ai03-2725/Orbit/OrbitX-PCB/Elecrow/OrbitX-Firmware-Flashing.docx

Firmware file is ai03_orbit_x_via.hex

Install instructions:

1. If computer does not have drivers for atmega32u4:
  a. Open qmk_toolbox.exe
  b. When QMK toolbox asks to install drivers, select Yes.

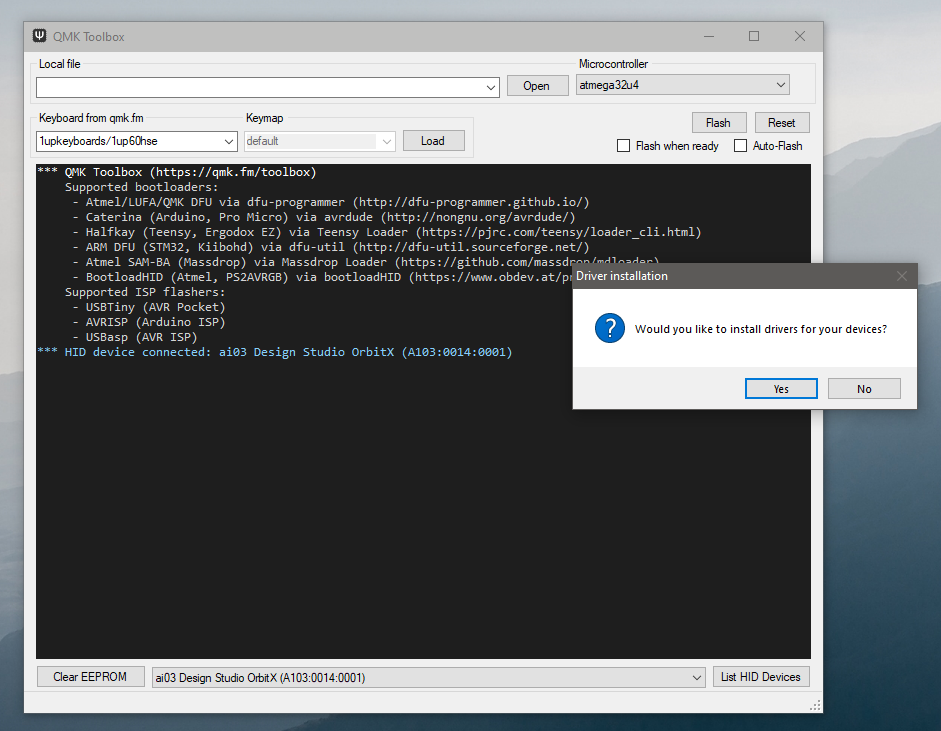
[picture p1: figure]

  c. The drivers will install slowly.

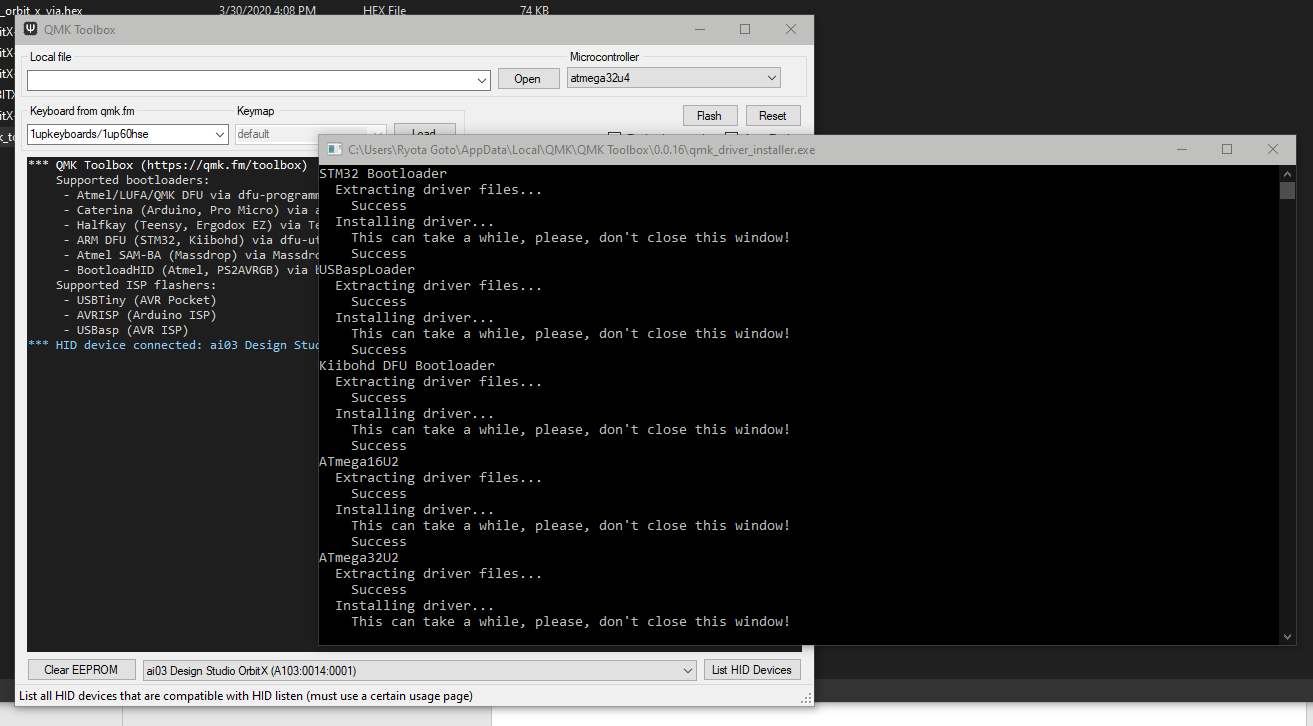
[picture p2: figure]

  d. Restart computer to finish driver install.
2. After drivers are installed, open qmk_toolbox.exe.
3. Click the Open button under “Local File”, and select the firmware file ai03_orbit_x_via.hex. /

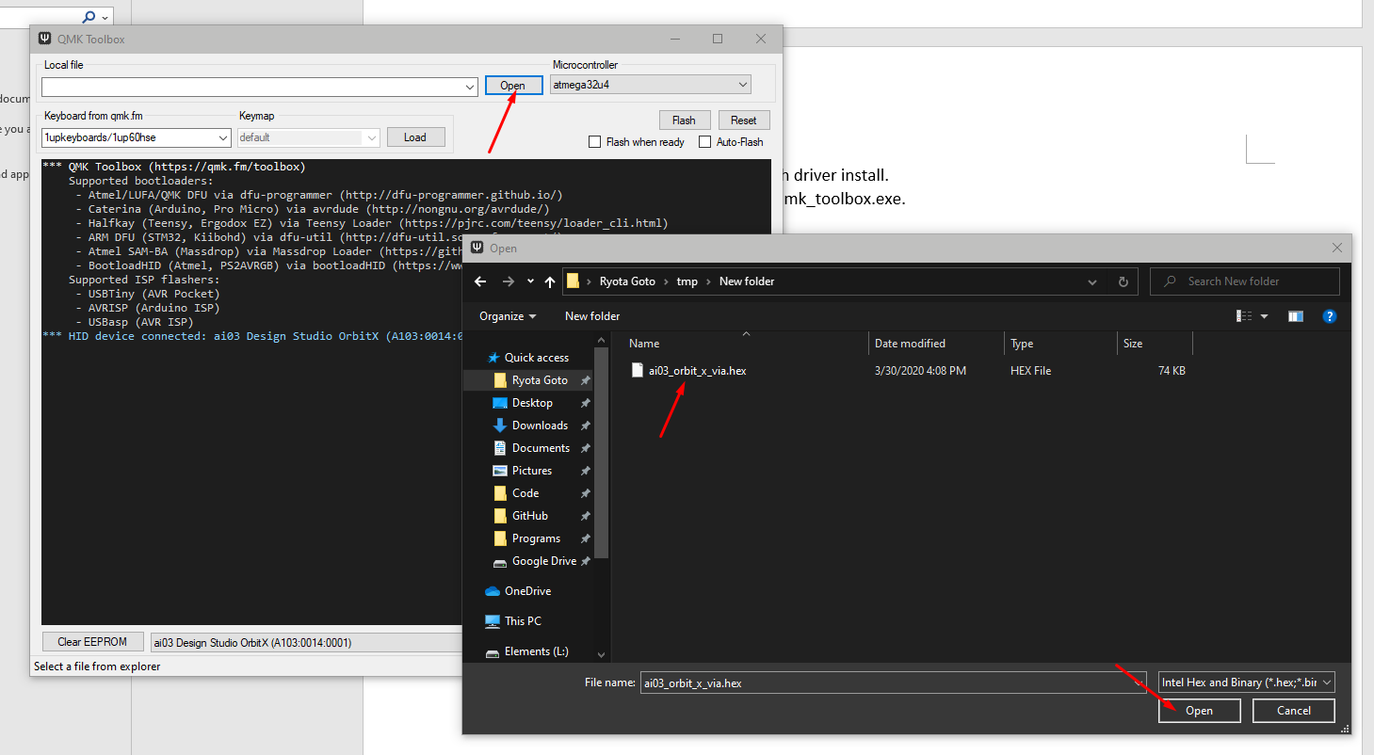
[picture p3: figure]

4. Select atmega32u4 for Microcontroller, and turn on “Flash when ready”.

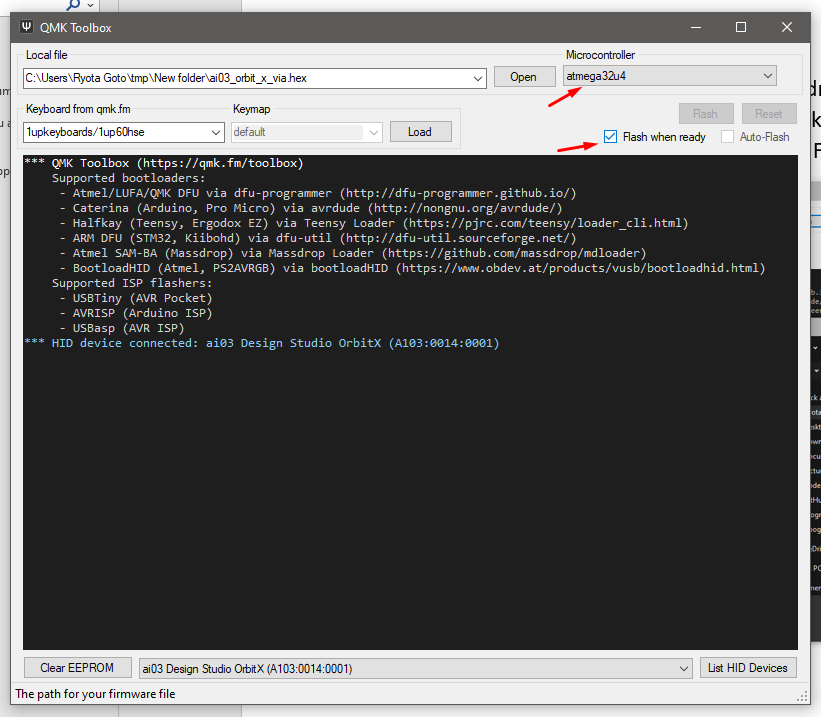
[picture p4: figure]

5. Connect the PCB. Firmware will automatically flash, and the device will appear as “ai03 Design Studio OrbitX” after success.
