ai03-2725/Orbit/OrbitX-PCB/JLCPCB/JLCSMT_Sample_BOM1.xlsx

Comment | Designator | Footprint | LCSC Part #（optional）
100nF | C4 C5 C6 C11 C12 C13 C15 C16 | C_0603_1608Metric | C14663
10uF | C7 C14 | C_0603_1608Metric | C19702
1uF | C3 C10 | C_0603_1608Metric | C15849
22pF | C1 C2 C8 C9 | C_0603_1608Metric | C1653
Schottky | D75 D76 | D_SOD-123 | C162059
1N4148 | D1 D2 D3 D4 D5 D6 D7 D8 D9 D10 D11 D12 D13 D14 D15 D16 D17 D18 D19 D20 D21 D22 D23 D24 D25 D26 D27 D28 D29 D30 D31 D32 D33 D34 D35 D36 D37 D38 D39 D40 D41 D42 D43 D44 D45 D46 D47 D48 | D_SOD-123 | C81598
Polyfuse 500mA | F1 F2 | Fuse_1206_3216Metric | C369159
10KΩ | R25 R67 R87 R88 | R_0603 | C25804
22Ω | R41 R42 R83 R84 | R_0603 | C23345
4.7KΩ | R9 R10 | R_0603 | C23162
5.1KΩ | R43 R44 R85 R86 | R_0603 | C23186
ATMEGA32u4-AU | U1 U3 | TQFP-44_10x10mm_P0.8mm | C44854
Crystal 16MHz | Y1 Y2 | Crystal_SMD_3225-4Pin_3.2x2.5mm | C13738
SW_Push | SW1 SW2 | SKQGADE010 | C318884
