ai03-2725/Orbit/OrbitX-PCB/Elecrow/OrbitX-Quote.xlsx

Sheet: PCB Specification
Orbit PCB Specification
PCB Quantity | 105pcs
Layer | 2layer
PCB Thickness | 1.6mm
Dimensions | 264mm*125mm
Castellated Hole | No
PCB Color | Matte Black
Surface Finish | HASL With Lead
Copper Weight | 1oz
Text Color | White
Different Design | 2
Please find more PCB information on our on-line PCB ordering Page
https://www.elecrow.com/pcb-manufacturing.html

Sheet: BOM
Orbit PCB
# | Reference | QTY | Value | Package | Manufacturer Part number | Description | SMD | THT | Original | Elecrow PN | Note
1 | C4 C5 C6 C11 C12 C13 C15 C16 | 8 | 0.1uF | C_0603_1608Metric | 490-8020-1-ND | Capacitor, Ceramic, 0603 | 16 |  | N
2 | C7 C14 | 2 | 10uF | C_0603_1608Metric | 490-12736-1-ND | Capacitor, Ceramic, 0603 | 4 |  | N
3 | C3 C10 | 2 | 1uF | C_0603_1608Metric | 490-10479-1-ND | Capacitor, Ceramic, 0603 | 4 |  | N
4 | C1 C2 C8 C9 | 4 | 22pF | C_0603_1608Metric | 490-1411-1-ND | Capacitor, Ceramic, 0603 | 8 |  | N
5 | D1 D2 D3 D4 D5 D6 D7 D8 D9 D10 D11 D12 D13 D14 D15 D16 D17 D18 D19 D20 D21 D22 D23 D24 D25 D26 D27 D28 D29 D30 D31 D32 D33 D34 D35 D36 D37 D38 D39 D40 D41 D42 D43 D44 D45 D46 D47 D48 | 48 | SOD123 | D_SOD-123 | 1N4148W-FDICT-ND | Diode, 1N4148, SOD-123 | 96 |  | N
6 | D75 D76 | 2 | Schottky | D_SOD-123 | MBRX120LF-TPMSCT-ND | Diode, schottky, forward voltage ≤0.5V, forward current ≥1A, DC reverse max ≥15V | 4 |  | N
7 | F1 F2 | 2 | 500mA | Fuse_1206_3216Metric | 507-1803-1-ND | Fuse, 1206, 500mA hold, 1A trip | 4 |  | N
8 | J1 J11 | 2 | PJ-3200B-4A | PJ-3200B-4A | PJ-320A | TRRS 3.5mm, PJ-320A |  | 8 | Y |  | https://item.taobao.com/item.htm?id=577065243473
9 | R25 R67 R87 R88 | 4 | 10k | R_0603_1608Metric | P10.0KHCT-ND | Resistor, 0603 | 8 |  | N
10 | R41 R42 R83 R84 | 4 | 22 | R_0603_1608Metric | P22.0HCT-ND | Resistor, 0603 | 8 |  | N
11 | R9 R10 | 2 | 4.7k | R_0603_1608Metric | P4.70KHCT-ND | Resistor, 0603 | 4 |  | N
12 | R43 R44 R85 R86 | 4 | 5.1k | R_0603_1608Metric | P5.10KHCT-ND | Resistor, 0603 | 8 |  | N
13 | SW1 SW2 | 2 | SW_Push | SKQGADE010 | SKQGADE010 | Buttom, SMT, 5.2 x 5.2mm | 8 |  | N
14 | U1 U3 | 2 | ATmega32U4-AU | TQFP-44_10x10mm_P0.8mm | ATMEGA32U4-AU-ND | Atmel ATMEGA32U4-AU | 88 |  | Y
15 | U2 U4 | 2 | PRTR5V0U2X | SOT143B | 1727-3884-1-ND | ESD Protection IC, PRTR5V0U2X,215 | 8 |  | N
16 | USB1 USB2 | 2 | HRO-TYPE-C-31-M-12 | HRO-TYPE-C-31-M-12-Assembly | TYPE-C-31-M-12 | USB-C 16-pin 2.0 connector | 24 | 8 | Y |  | https://lcsc.com/product-detail/USB-Connectors_Korean-Hroparts-Elec-TYPE-C-31-M-12_C165948.html
17 | Y1 Y2 | 2 | 16MHz | Crystal_SMD_3225-4Pin_3.2x2.5mm | X1E000021037500 | Crystal, 16MHz, 3.2 x 2.5mm | 8 |  | Y
 |  |  |  |  |  | total： | 300 | 16
 | Declare：
 | 1、If the component should be original like Digi-key or Mouser，the component must have complete Manufacture part number

Sheet: Parts Mapping
Please see file ORBITX-PCB-PRINT.pdf

Sheet: Position File
Please see file OrbitX-bottom-pos.csv

Sheet: Firmware
See OrbitX-Firmware-Flashing.docx
