ai03-2725/Orbit/OrbitX-PCB/Elecrow/ORBITX-PCB-PRINT.pdf

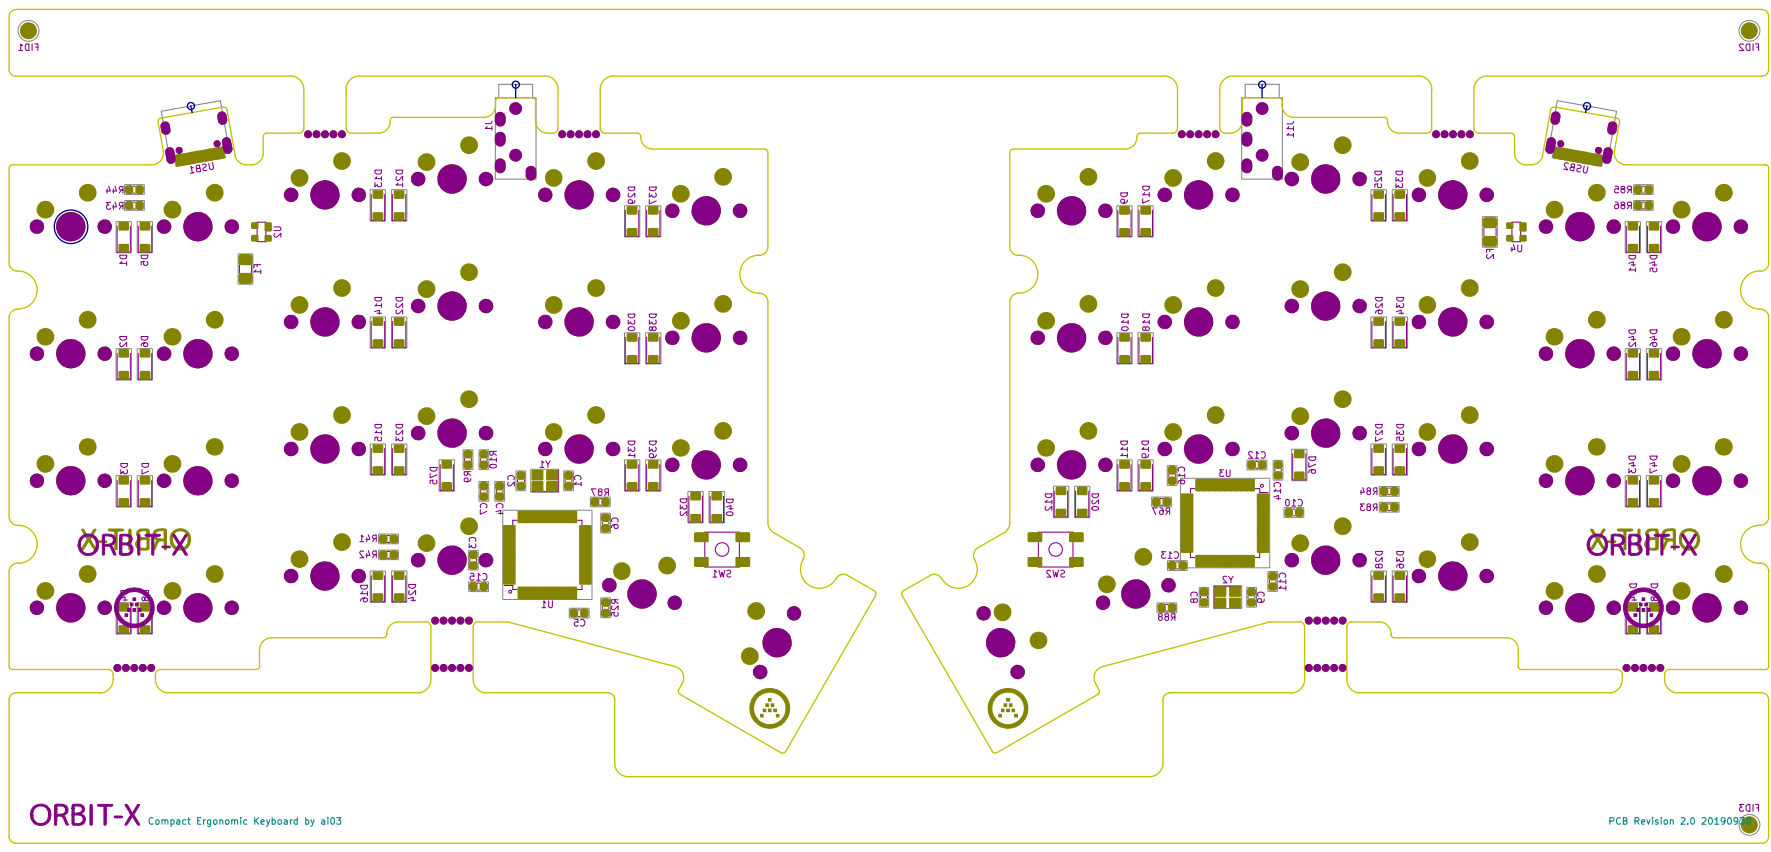
[picture p5: page 1]
