ai03-2725/Orbit/OrbitX-PCB/Orbit.kicad_pcb

## KiCad design OrbitX-PCB/Orbit.kicad_pcb (2019-11-10)

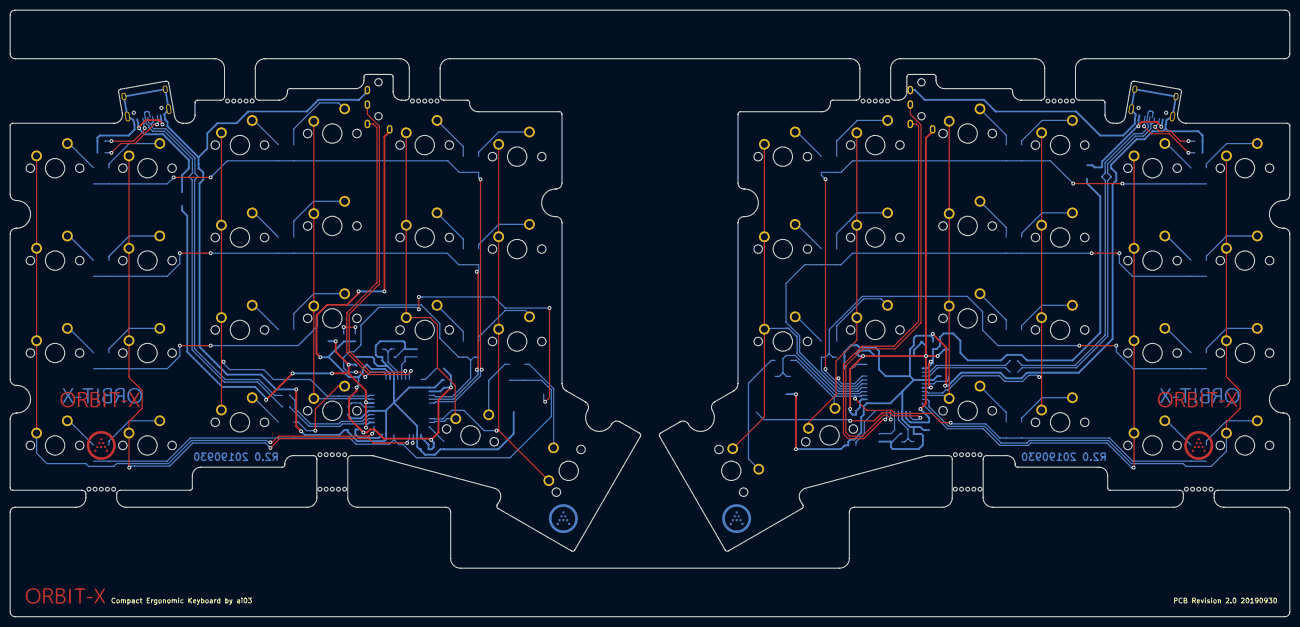
[picture p7: board OrbitX-PCB/Orbit.kicad_pcb from above]

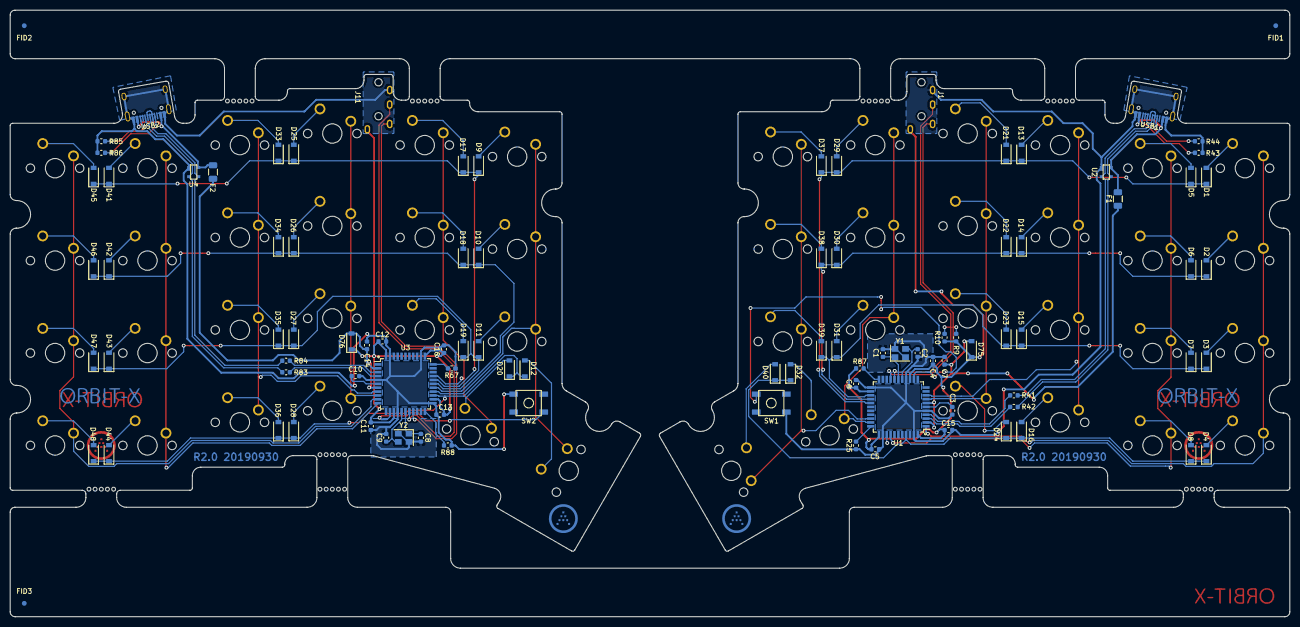
[picture p8: board OrbitX-PCB/Orbit.kicad_pcb from below]

Board: 2 copper layers, 263.8 x 125.0 mm, 155 parts (97 on the bottom side), 104 nets.

Parts:
C1, C2, C8, C9: 22pF; C_0603_1608Metric
C3, C10: 1uF; C_0603_1608Metric
C4, C5, C6, C11, C12, C13, C15, C16: 0.1uF; C_0603_1608Metric
C7, C14: 10uF; C_0603_1608Metric
D1, D2, D3, D4, D5, D6, D7, D8, D9, D10, D11, D12, D13, D14, D15, D16, D17, D18, D19, D20, D21, D22, D23, D24, D25, D26, D27, D28, D29, D30, D31, D32, D33, D34, D35, D36, D37, D38, D39, D40, D41, D42, D43, D44, D45, D46, D47, D48: SOD123; D_SOD-123
D75, D76: Schottky; D_SOD-123
F1, F2: 500mA; Fuse_1206_3216Metric
FID1, FID2, FID3: Fiducial; Fiducial_1mm_Dia_2.54mm_Outer_CopperTop
J1, J11: PJ-3200B-4A
J3, J5, J6, J7, J9, J13, J14, J17, J18, J19: Breakaway_Tabs; breakaway-mousebites
MX1, MX2, MX3, MX4, MX5, MX6, MX7, MX8, MX9, MX10, MX11, MX13, MX14, MX15, MX16, MX17, MX18, MX19, MX20, MX21, MX22, MX23, MX24, MX25, MX26, MX27, MX28, MX29, MX30, MX31, MX32, MX33, MX34, MX35, MX36, MX37, MX38, MX39, MX41, MX42, MX43, MX44, MX45, MX46, MX47, MX48: MX-NoLED; MXOnly-1U-NoLED
MX12, MX40: MX-NoLED; MXOnly-1.5U-NoLED
R9, R10: 4.7k; R_0603_1608Metric
R25, R67, R87, R88: 10k; R_0603_1608Metric
R41, R42, R83, R84: 22; R_0603_1608Metric
R43, R44, R85, R86: 5.1k; R_0603_1608Metric
SW1, SW2: SW_Push; SKQGADE010
U1, U3: ATmega32U4-AU; TQFP-44_10x10mm_P0.8mm
U2, U4: PRTR5V0U2X; SOT143B
USB1, USB2: HRO-TYPE-C-31-M-12; HRO-TYPE-C-31-M-12-Assembly
Y1, Y2: 16MHz; Crystal_SMD_3225-4Pin_3.2x2.5mm

Connections:
+5V: C4.1, C5.1, C6.1, C15.1, D75.1, J1.4, R9.1, R10.1, R87.1, U1.14, U1.24, U1.34, U1.44
+5VA: C11.1, C12.1, C13.1, C16.1, D76.1, J11.4, U3.14, U3.24, U3.34, U3.44
COL0: MX1.1, MX2.1, MX3.1, MX4.1, U1.1
COL0-R: MX9.1, MX10.1, MX11.1, MX12.1, U3.26
COL1: MX5.1, MX6.1, MX7.1, MX8.1, U1.37
COL1-R: MX17.1, MX18.1, MX19.1, MX20.1, U3.30
COL2: MX13.1, MX14.1, MX15.1, MX16.1, U1.9
COL2-R: MX25.1, MX26.1, MX27.1, MX28.1, U3.9
COL3: MX21.1, MX22.1, MX23.1, MX24.1, U1.8
COL3-R: MX33.1, MX34.1, MX35.1, MX36.1, U3.8
COL4: MX29.1, MX30.1, MX31.1, MX32.1, U1.32
COL4-R: MX41.1, MX42.1, MX43.1, MX44.1, U3.11
COL5: MX37.1, MX38.1, MX39.1, MX40.1, U1.31
COL5-R: MX45.1, MX46.1, MX47.1, MX48.1, U3.10
D+: R41.1, U1.4
D+-R: R83.1, U3.4
D-: R42.1, U1.3
D--R: R84.1, U3.3
GND: C1.2, C2.2, C3.2, C4.2, C5.2, C6.2, C7.2, C15.2, J1.1, R25.1, R43.2, R44.2, SW1.1, U1.5, U1.15, U1.23, U1.35, U1.43, U2.1, USB1.1, USB1.12, USB1.13, Y1.2, Y1.4
GNDA: C8.2, C9.2, C10.2, C11.2, C12.2, C13.2, C14.2, C16.2, J11.1, R67.1, R85.2, R86.2, R88.1, SW2.1, U3.5, U3.15, U3.23, U3.35, U3.43, U4.1, USB2.1, USB2.12, USB2.13, Y2.2, Y2.4
HDETECT: R87.2, U1.22
HDETECT-R: R88.2, U3.22
unnamed: C1.1, U1.17, Y1.1
unnamed: C2.1, U1.16, Y1.3
unnamed: C3.1, U1.6
unnamed: C8.1, U3.17, Y2.1
unnamed: C9.1, U3.16, Y2.3
unnamed: C10.1, U3.6
unnamed: D1.2, MX1.2
unnamed: D2.2, MX2.2
unnamed: D3.2, MX3.2
unnamed: D4.2, MX4.2
unnamed: D5.2, MX5.2
unnamed: D6.2, MX6.2
unnamed: D7.2, MX7.2
unnamed: D8.2, MX8.2
unnamed: D9.2, MX9.2
unnamed: D10.2, MX10.2
unnamed: D11.2, MX11.2
unnamed: D12.2, MX12.2
unnamed: D13.2, MX13.2
unnamed: D14.2, MX14.2
unnamed: D15.2, MX15.2
unnamed: D16.2, MX16.2
unnamed: D17.2, MX17.2
unnamed: D18.2, MX18.2
unnamed: D19.2, MX19.2
unnamed: D20.2, MX20.2
unnamed: D21.2, MX21.2
unnamed: D22.2, MX22.2
unnamed: D23.2, MX23.2
unnamed: D24.2, MX24.2
unnamed: D25.2, MX25.2
unnamed: D26.2, MX26.2
unnamed: D27.2, MX27.2
unnamed: D28.2, MX28.2
unnamed: D29.2, MX29.2
unnamed: D30.2, MX30.2
unnamed: D31.2, MX31.2
unnamed: D32.2, MX32.2
unnamed: D33.2, MX33.2
unnamed: D34.2, MX34.2
unnamed: D35.2, MX35.2
unnamed: D36.2, MX36.2
unnamed: D37.2, MX37.2
unnamed: D38.2, MX38.2
unnamed: D39.2, MX39.2
unnamed: D40.2, MX40.2
unnamed: D41.2, MX41.2
unnamed: D42.2, MX42.2
unnamed: D43.2, MX43.2
unnamed: D44.2, MX44.2
unnamed: D45.2, MX45.2
unnamed: D46.2, MX46.2
unnamed: D47.2, MX47.2
unnamed: D48.2, MX48.2
unnamed: R25.2, U1.33
unnamed: R41.2, U2.2, USB1.6, USB1.8
unnamed: R42.2, U2.3, USB1.5, USB1.7
unnamed: R43.1, USB1.10
unnamed: R44.1, USB1.4
unnamed: R67.2, U3.33
unnamed: R83.2, U4.2, USB2.6, USB2.8
unnamed: R84.2, U4.3, USB2.5, USB2.7
unnamed: R85.1, USB2.10
unnamed: R86.1, USB2.4
RESET: SW1.2, U1.13
RESET-R: SW2.2, U3.13
ROW0: D1.1, D5.1, D13.1, D21.1, D29.1, D37.1, U1.27
ROW0-R: D9.1, D17.1, D25.1, D33.1, D41.1, D45.1, U3.29
ROW1: D2.1, D6.1, D14.1, D22.1, D30.1, D38.1, U1.26
ROW1-R: D10.1, D18.1, D26.1, D34.1, D42.1, D46.1, U3.27
ROW2: D3.1, D7.1, D15.1, D23.1, D31.1, D39.1, U1.25
ROW2-R: D11.1, D19.1, D27.1, D35.1, D43.1, D47.1, U3.28
ROW3: D4.1, D8.1, D16.1, D24.1, D32.1, D40.1, U1.41
ROW3-R: D12.1, D20.1, D28.1, D36.1, D44.1, D48.1, U3.25
SCL: J1.2, R10.2, U1.18
SCL-R: J11.2, U3.18
SDA: J1.3, R9.2, U1.19
SDA-R: J11.3, U3.19
VBUS: C7.1, D75.2, F1.1, U1.2, U1.7
VCC: F1.2, U2.4, USB1.2, USB1.11
VDC: C14.1, D76.2, F2.1, U3.2, U3.7
VDD: F2.2, U4.4, USB2.2, USB2.11
