ai03-2725/Orbit/(commit log)

2019-10-01 Build new OrbitX PCB
    [Orbit.kicad_pcb]
2019-10-01 Finalize decal
    [Orbit.kicad_pcb]
2019-10-01 Generate gerber
    [Orbit-B_Cu.gbl, Orbit-B_Mask.gbs, Orbit-B_Paste.gbp, Orbit-B_SilkS.gbo, Orbit-Edge_Cuts.gm1, Orbit-F_Cu.gtl, Orbit-F_Mask.gts, Orbit-F_Paste.gtp]
2019-11-10 JLC files
    [JLCSMT_Sample_BOM1.xlsx, Orbit.kicad_pcb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]
2020-03-30 Update orbit-x to production copy
    [Orbit.kicad_pcb, OrbitX-Quote.xlsx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]
